IliyanAntov/MetalDetector/README.md

 <h1 align="center"> Металотърсач с биене на честоти<br/><br/>
 BFO (Beat Frequency Oscillator) metal detector</h1>

## [Документация](./Documentation/KR_EUIU_Iliyan_Antov_101220020.pdf)

## Блокова схема:
<p align="center">
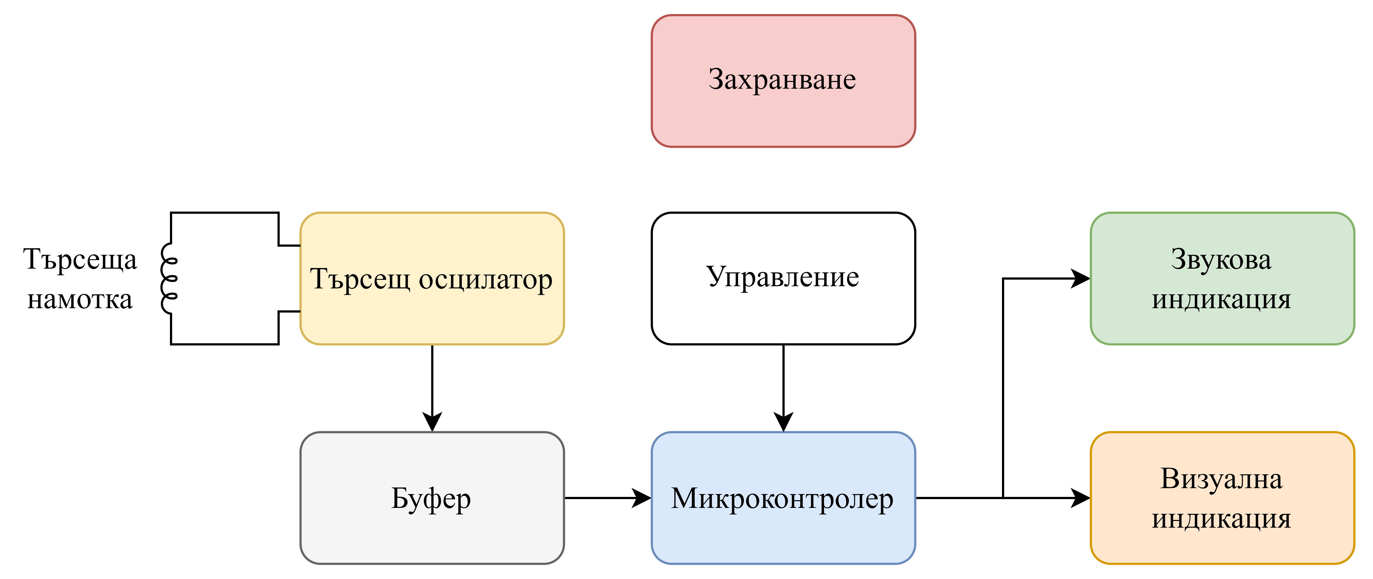
[picture p1: Documentation/Images/Metal_detector_block_scheme.png]
  
</p>

## Принципна електрическа схема:
<p align="center">
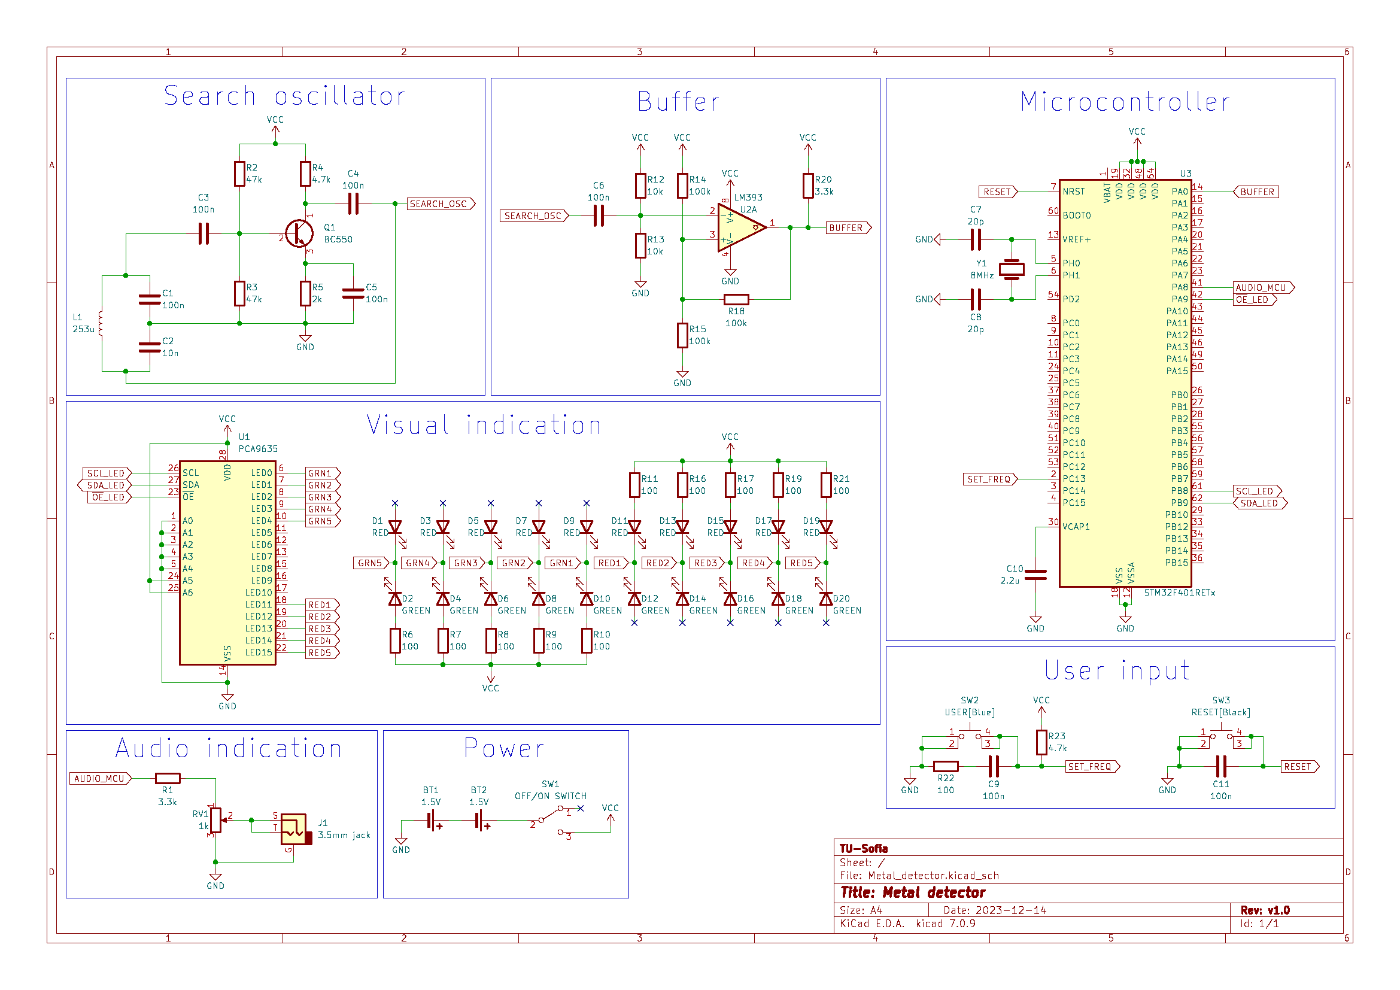
[picture p2: Documentation/Images/Schematic.png]
  
</p>

## Реализиран прототип:
<p align="center" float="left">
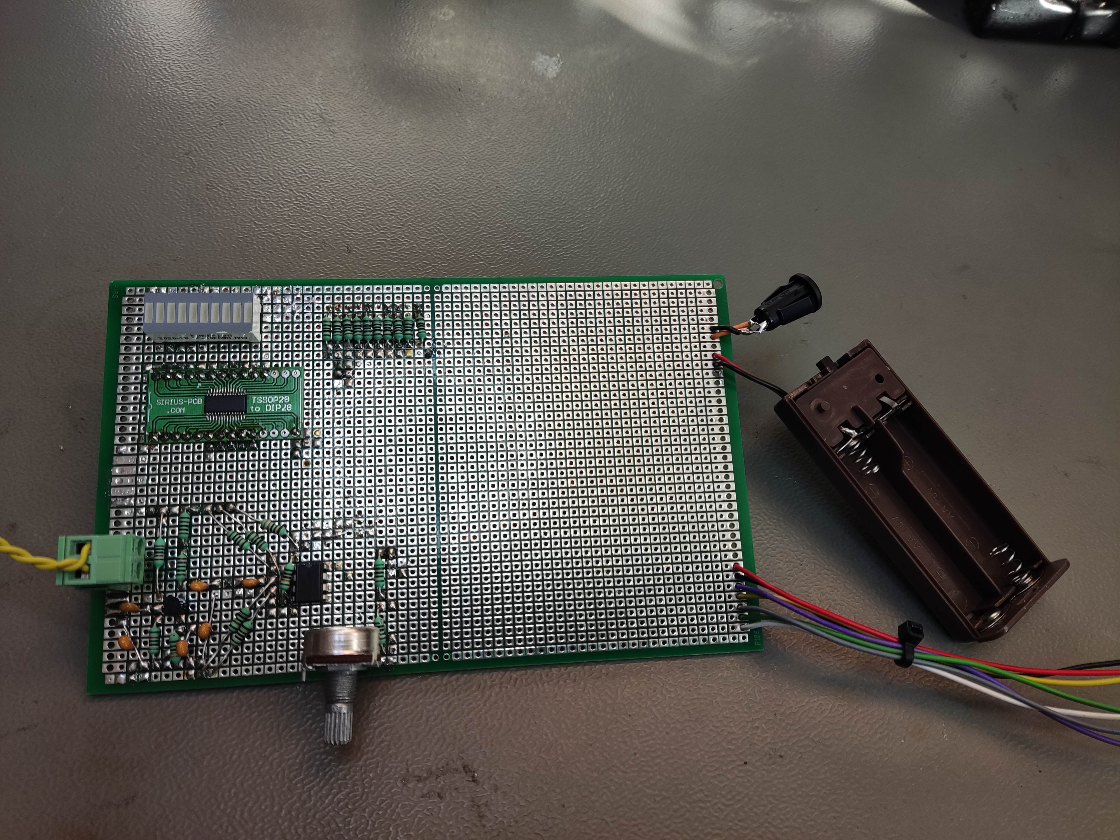
[picture p3: Documentation/Images/Dev_board_3.jpg]
  
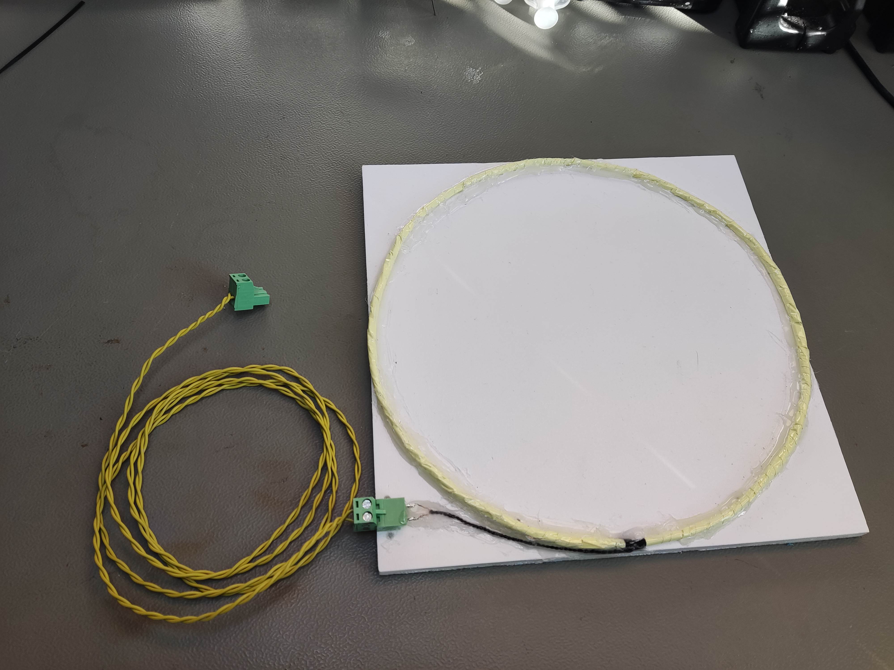
[picture p4: Documentation/Images/Search_coil_1.jpg]
  
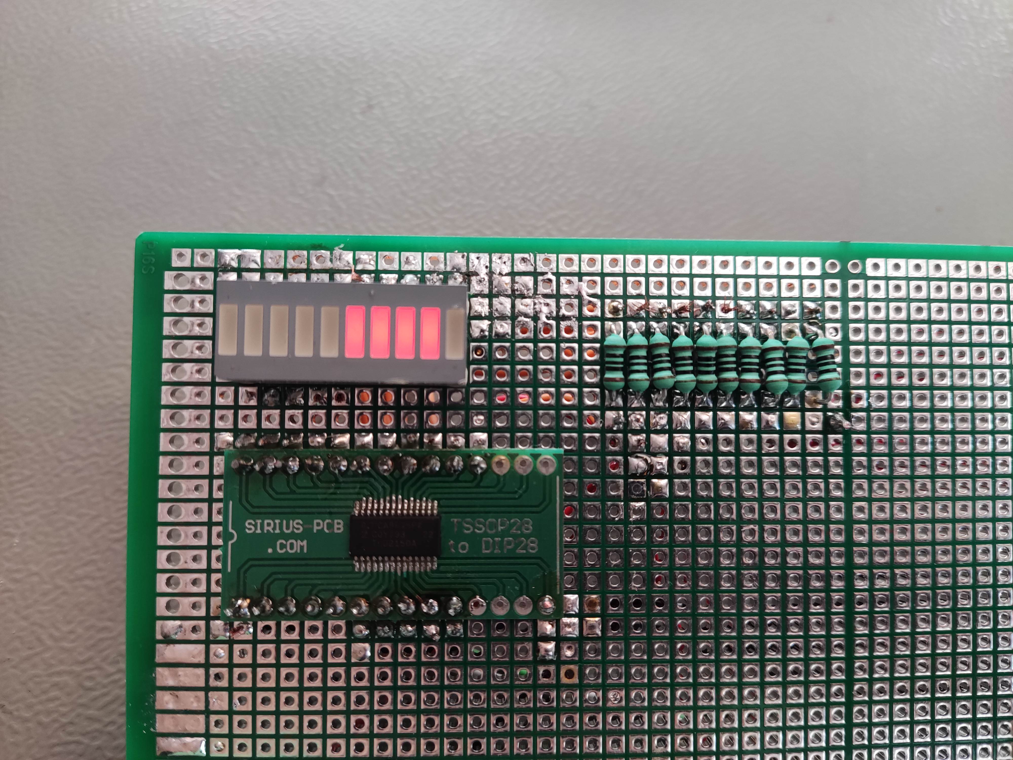
[picture p5: Documentation/Images/Magnetic_material_detection.jpg]
  
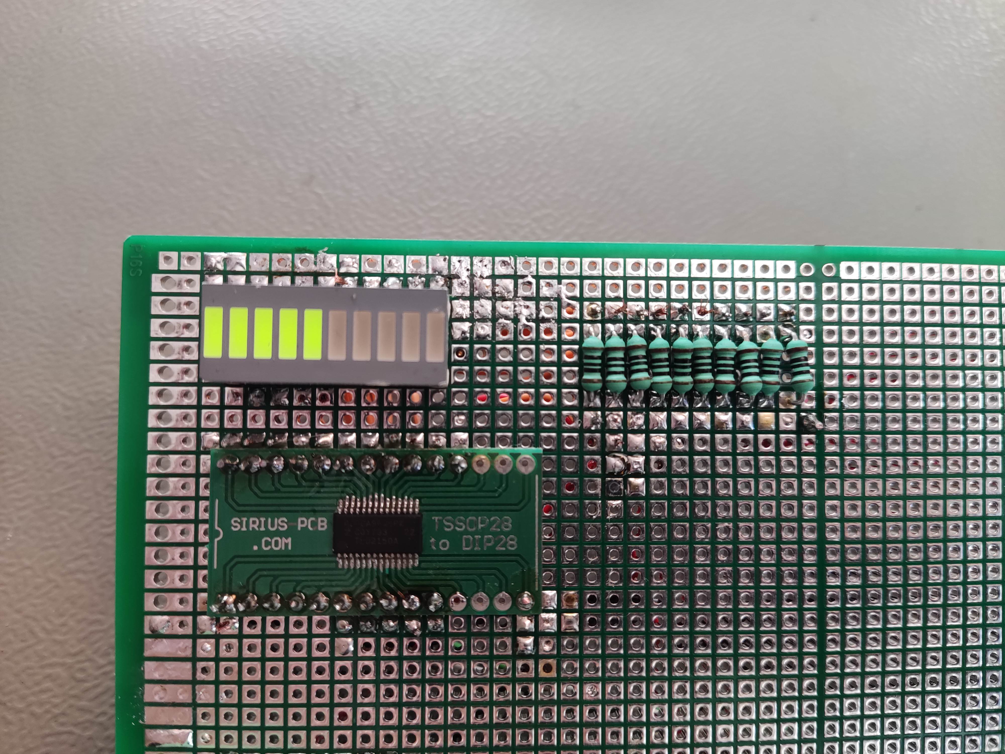
[picture p6: Documentation/Images/Non-magnetic_material_detection.jpg]
  
</p>

## Използвани технологии:
* Firmware: C/C++
* MCU platform: STM32
* Schematics/Layout: KiCAD

## Автор:
Илиян Антов - [Iliyan Antov](https://github.com/IliyanAntov) - [i.antov2@gmail.com](i.antov2@gmail.com)
