IliyanAntov/MetalDetector/Documentation/Images/Dev_board_1.jpg

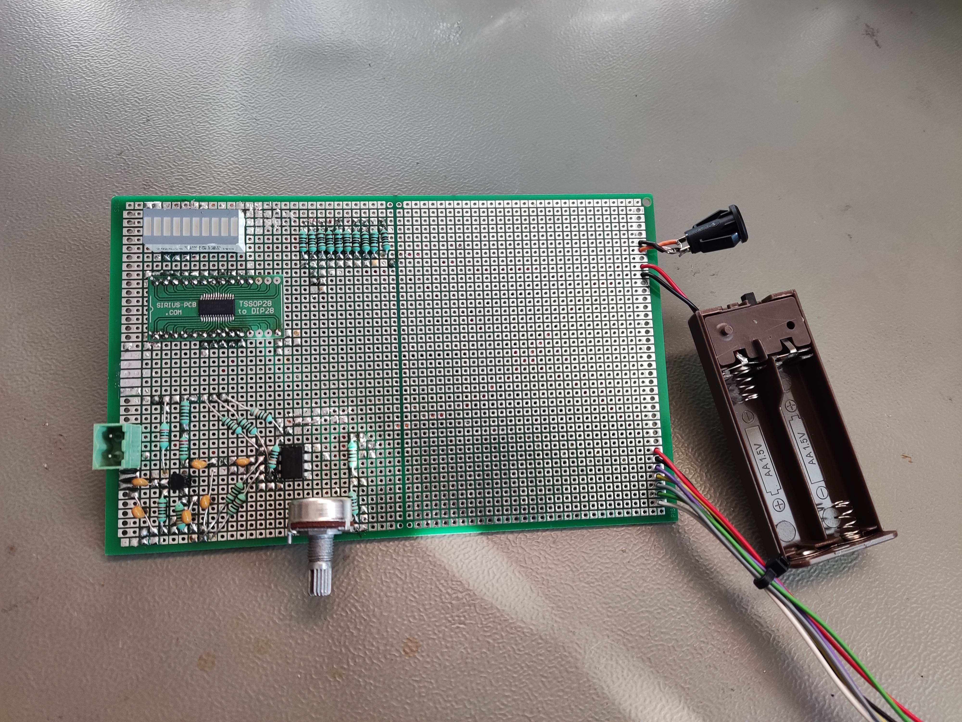
Documentation/Images/Dev_board_1.jpg
