IliyanAntov/MetalDetector/Documentation/Images/Dev_board_2.jpg

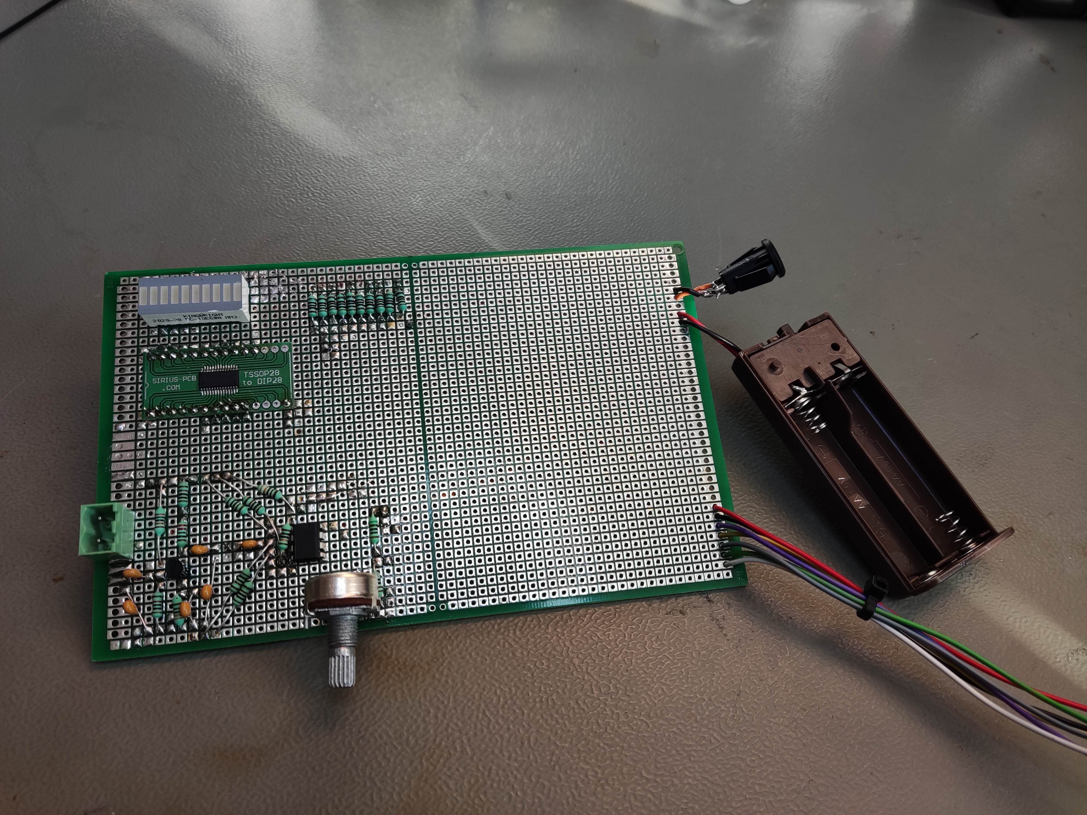
Documentation/Images/Dev_board_2.jpg
