IliyanAntov/MetalDetector/Documentation/Images/Dev_board_4.jpg

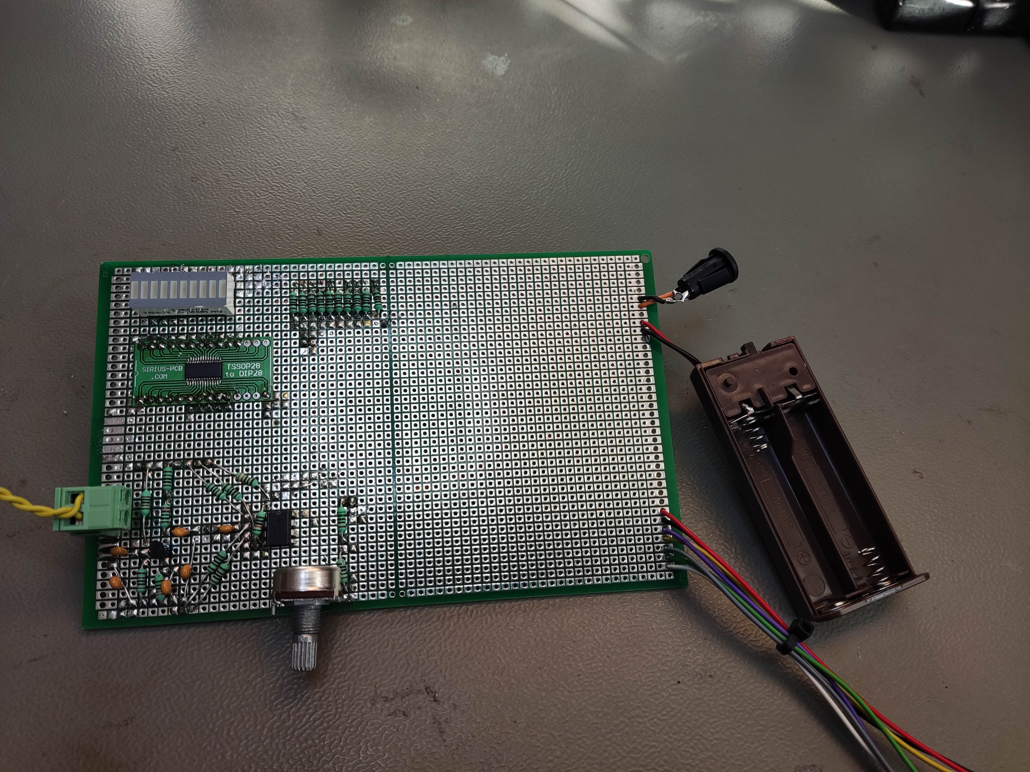
Documentation/Images/Dev_board_4.jpg
