IliyanAntov/MetalDetector/Documentation/Images/MCU_board_1.jpg

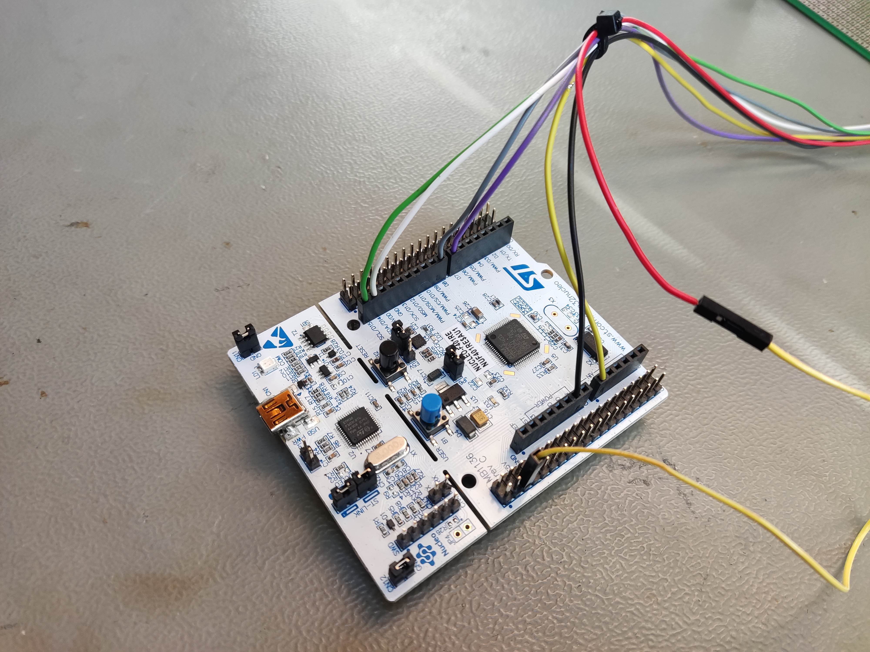
Documentation/Images/MCU_board_1.jpg
