IliyanAntov/MetalDetector/Documentation/Images/MCU_board_2.jpg

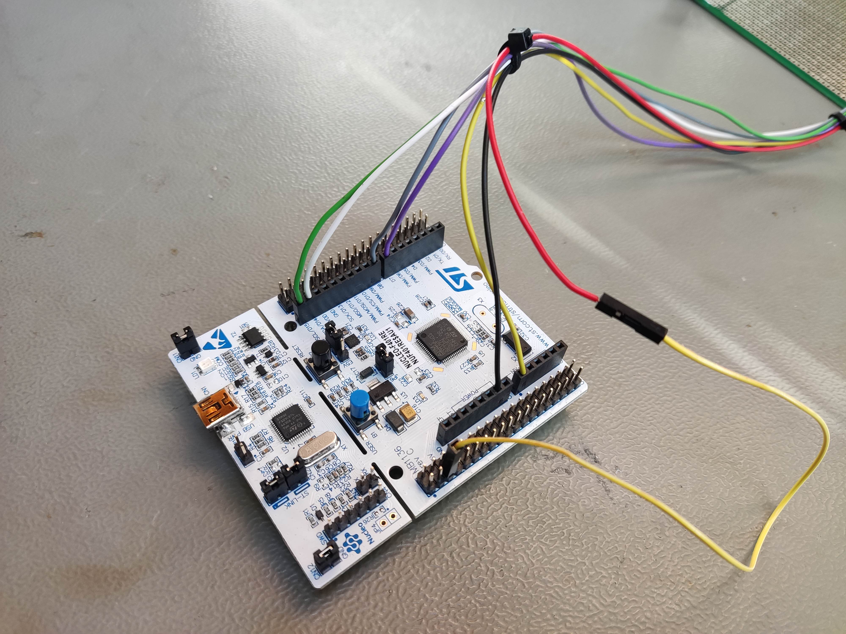
Documentation/Images/MCU_board_2.jpg
