IliyanAntov/MetalDetector/Simulation/metal_detector_sim.asc

C1: cap; 1µ
C10: cap; 100n
C16: cap; 100n
C17: cap; 100n
C18: cap; 100n
C19: cap; 10n
L1: ind; 281.45µ
Q2: npn; BC547B
R1: res; 10k
R2: res; 10k
R12: res; 1.2k
R17: res; 10k
R18: res; 100k
R19: res; 330
R20: res; 10k
R21: res; 20k
R22: res; 10k
U2: LTC6752
V6: voltage; 3
V7: signal; SINE(0 1m 1Meg 0 0 0 20)
Named nets: 0, +3V, out_search, out_schmigger, v-, v+
.tran 5m
;ac dec 100 1 1Meg
.op
