IliyanAntov/MetalDetector/Code/Core/Src/main.c

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
/* Includes ------------------------------------------------------------------*/
#include "main.h"

/* USER CODE BEGIN Includes */
#include <stdlib.h>
/* USER CODE END Includes */

/* USER CODE BEGIN PD */
#define FREQUENCY_DEADZONE 5
#define IDLE_FREQUENCY 1000 //1kHz
#define OFFSET_AMPLIFICATION 1

#define LED_DRIVER_ADDR (96 << 1)
#define INDICATOR_FIRST_STEP_HZ 20
#define INDICATOR_STEP_AMPLIFICATION 3
/* USER CODE END PD */

I2C_HandleTypeDef hi2c1;

TIM_HandleTypeDef htim1;
TIM_HandleTypeDef htim2;

UART_HandleTypeDef huart2;

/* USER CODE BEGIN PV */
float averageFrequency, zeroFrequency;
/* USER CODE END PV */

void SystemClock_Config(void);
static void MX_GPIO_Init(void);
static void MX_USART2_UART_Init(void);
static void MX_TIM2_Init(void);
static void MX_TIM1_Init(void);
static void MX_I2C1_Init(void);
/* USER CODE BEGIN PFP */
void Set_PWM_Frequency_Offset(float);
void Init_LED_Driver();
void Set_LED_Indicator(float);
/* USER CODE END PFP */

/**
  * @brief  The application entry point.
  * @retval int
  */
int main(void)
{
  /* MCU Configuration--------------------------------------------------------*/

  /* Reset of all peripherals, Initializes the Flash interface and the Systick. */
  HAL_Init();

  /* Configure the system clock */
  SystemClock_Config();

  /* Initialize all configured peripherals */
  MX_GPIO_Init();
  MX_USART2_UART_Init();
  MX_TIM2_Init();
  MX_TIM1_Init();
  MX_I2C1_Init();
  /* USER CODE BEGIN 2 */
  HAL_TIM_IC_Start_IT(&htim2, TIM_CHANNEL_1);
  HAL_TIM_PWM_Start(&htim1, TIM_CHANNEL_1);
  Init_LED_Driver();
  /* USER CODE END 2 */

  /* Infinite loop */
  /* USER CODE BEGIN WHILE */
  HAL_Delay(500);
  zeroFrequency = averageFrequency;

  float frequencyOffset, currentOffset;

  while (1)
  {
    /* USER CODE END WHILE */

    /* USER CODE BEGIN 3 */
      frequencyOffset = (averageFrequency - zeroFrequency);
      if ((frequencyOffset > FREQUENCY_DEADZONE) || (frequencyOffset < -FREQUENCY_DEADZONE)){
          Set_PWM_Frequency_Offset(frequencyOffset);
          Set_LED_Indicator(frequencyOffset);
          currentOffset = frequencyOffset;
      }
      else if(currentOffset != 0){
          Set_PWM_Frequency_Offset(0);
          Set_LED_Indicator(0);
          currentOffset = 0;
      }

  }
  /* USER CODE END 3 */
}

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
/* USER CODE BEGIN 4 */
void Set_PWM_Frequency_Offset(float frequencyOffset){

    int frequencyOffsetScaled = (int)(frequencyOffset*OFFSET_AMPLIFICATION);

    int newARR = (1000000/(IDLE_FREQUENCY-frequencyOffsetScaled)) - 1;
    int newCompare = newARR/2 - 1;
    __HAL_TIM_SET_AUTORELOAD(&htim1, newARR);
    __HAL_TIM_SET_COMPARE(&htim1, TIM_CHANNEL_1, newCompare);

}

void Init_LED_Driver(){

//    HAL_StatusTypeDef ret;
    uint8_t buf[30];

    //Sequential programming of all registers
    buf[0] = 0x80;
    //MODE1 register value
    buf[1] = 0x01;
    //MODE2 register value
    buf[2] = 0x05;

    //PWM0-PWM15 registers values (255)
    for(int i = 0; i < 16; i++){
        buf[3+i] = 0xFF;
    }

    //GRPPWM register value (48/256)
    buf[19] = 0x30;
    //GRPFREQ register value
    buf[20] = 0x00;

    for(int i=0; i<4; i++){
        buf[21+i] = 0xFF;
    }

    HAL_I2C_Master_Transmit(&hi2c1, LED_DRIVER_ADDR, buf, 25, HAL_MAX_DELAY);


    HAL_GPIO_WritePin(OE_GPIO_Port, OE_Pin, GPIO_PIN_RESET);

}

void Set_LED_Indicator(float frequencyOffset){

//    HAL_StatusTypeDef ret;
    uint8_t buf[5];
    buf[0] = 0x94;
    buf[1] = 0x00;
    buf[2] = 0x00;
    buf[3] = 0x00;
    buf[4] = 0x00;
    int frequencyOffsetAbs = (int)frequencyOffset;
    int indicator_step_hz = INDICATOR_FIRST_STEP_HZ;

    if(frequencyOffset == 0){
        //Sequential programming of registers LEDOUT0 to LEDOUT4
        buf[1] = 0x00;
        buf[2] = 0x00;
        buf[3] = 0x00;
        buf[4] = 0x00;
        HAL_I2C_Master_Transmit(&hi2c1, LED_DRIVER_ADDR, buf, 5, HAL_MAX_DELAY);
        return;
    }

    int currentReg = 1;
    // Non-magnetic
    if(frequencyOffset > 0){
        buf[1] = 0x03;
        currentReg = 1;
    }

    // Magnetic
    else{
        // LEDOUT3
        buf[3] = 0xFF;
        currentReg = 4;
        frequencyOffsetAbs *= -1;
    }

    if (frequencyOffsetAbs > indicator_step_hz){

        for(int i = 0; i < 3; i++){
            buf[currentReg] <<= 2;
            buf[currentReg] += 0x03;
            frequencyOffsetAbs -= indicator_step_hz;
            indicator_step_hz *= INDICATOR_STEP_AMPLIFICATION;

            if(frequencyOffsetAbs < indicator_step_hz)
                break;
        }
        if(frequencyOffsetAbs > indicator_step_hz){
            if(currentReg == 1){
                buf[currentReg+1] = 0x03;
            }
            else{
                buf[currentReg] <<= 2;
                buf[currentReg] += 0x03;
            }
        }
    }
    else{
        int a = 0;
    }

    HAL_I2C_Master_Transmit(&hi2c1, LED_DRIVER_ADDR, buf, 5, HAL_MAX_DELAY);

}
/* USER CODE END 4 */
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
