IliyanAntov/MetalDetector/Code/Core/Inc/main.h

#define BUTTON_BLUE_Pin GPIO_PIN_13
#define BUTTON_BLUE_GPIO_Port GPIOC
#define BUTTON_BLUE_EXTI_IRQn EXTI15_10_IRQn
#define GENERATOR_IN_Pin GPIO_PIN_0
#define GENERATOR_IN_GPIO_Port GPIOA
#define USART_TX_Pin GPIO_PIN_2
#define USART_TX_GPIO_Port GPIOA
#define USART_RX_Pin GPIO_PIN_3
#define USART_RX_GPIO_Port GPIOA
#define LED_GREEN_Pin GPIO_PIN_5
#define LED_GREEN_GPIO_Port GPIOA
#define AUDIO_OUT_Pin GPIO_PIN_8
#define AUDIO_OUT_GPIO_Port GPIOA
#define OE_Pin GPIO_PIN_9
#define OE_GPIO_Port GPIOA
#define TMS_Pin GPIO_PIN_13
#define TMS_GPIO_Port GPIOA
#define TCK_Pin GPIO_PIN_14
#define TCK_GPIO_Port GPIOA
#define SWO_Pin GPIO_PIN_3
#define SWO_GPIO_Port GPIOB
