IliyanAntov/MetalDetector/(commit log)

2023-12-14 Added block diagram and schematic
    [Metal_detector.kicad_sch]
2023-12-15 Edited the oscillator block and wrote documentation for it
    [Metal_detector.kicad_sch]
2023-12-16 Edited and documented the search oscillator, buffer and mcu blocks
    [Metal_detector.kicad_sch]
2023-12-16 Documented all blocks, made some small changes to the schematic
    [Metal_detector.kicad_sch]
